Emrecanbl/ESP32-PCB-Drone/Photos/PCB_Bottom_3D_Model.png

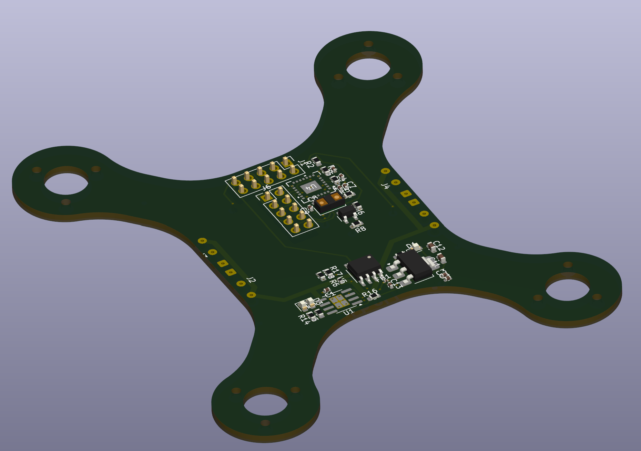
Photos/PCB_Bottom_3D_Model.png
