Emrecanbl/ESP32-PCB-Drone/Photos/PCB_Bottom_Schematic.png

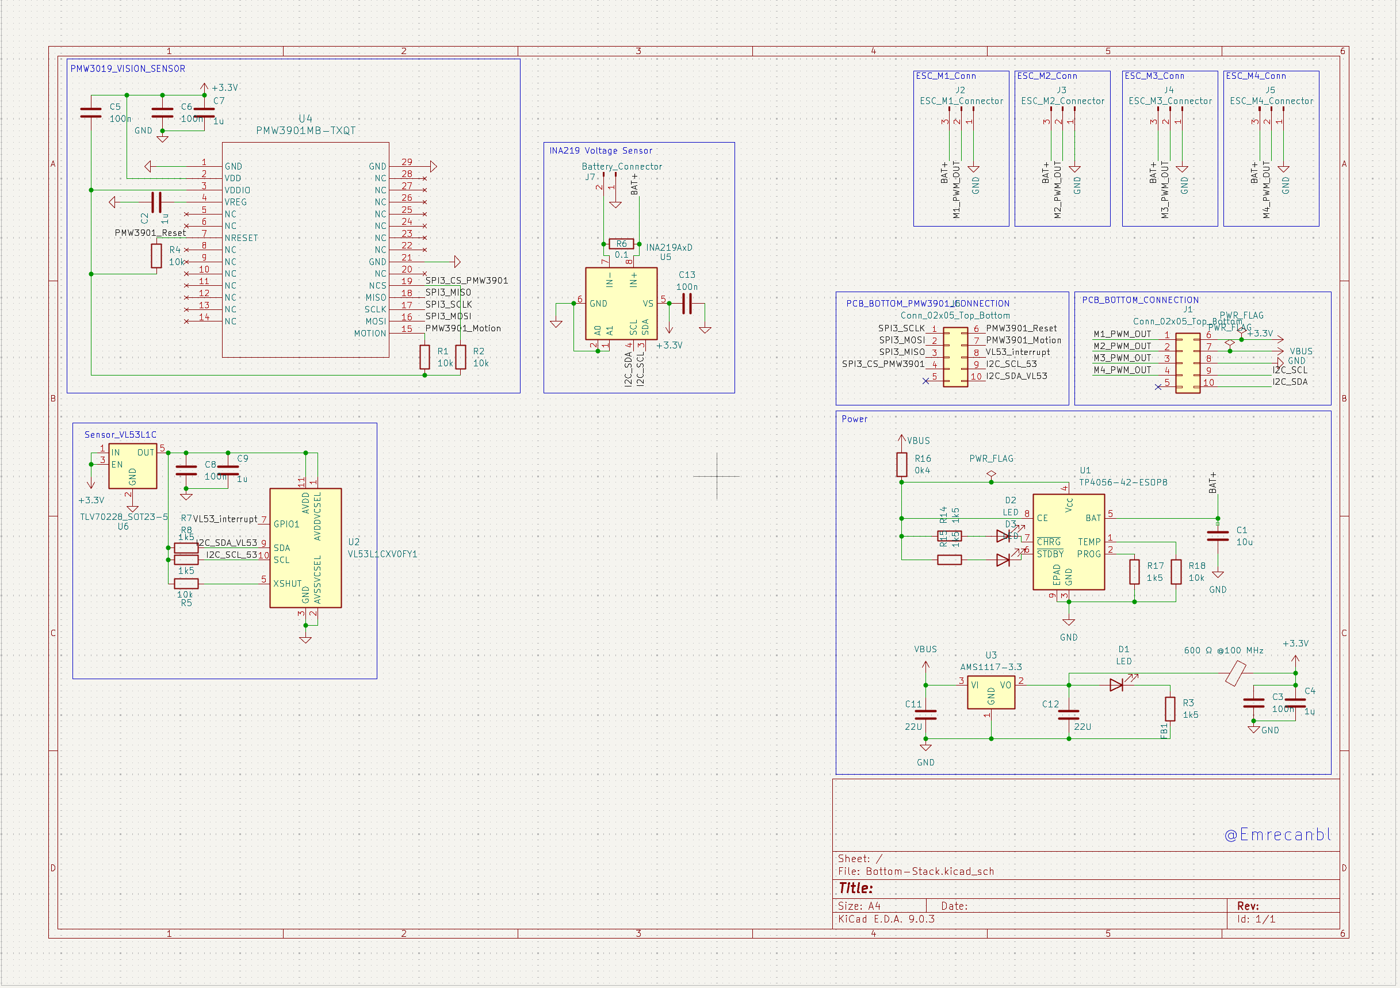
Photos/PCB_Bottom_Schematic.png
