Emrecanbl/ESP32-PCB-Drone/Photos/PCB_Bottom_Tracing.png

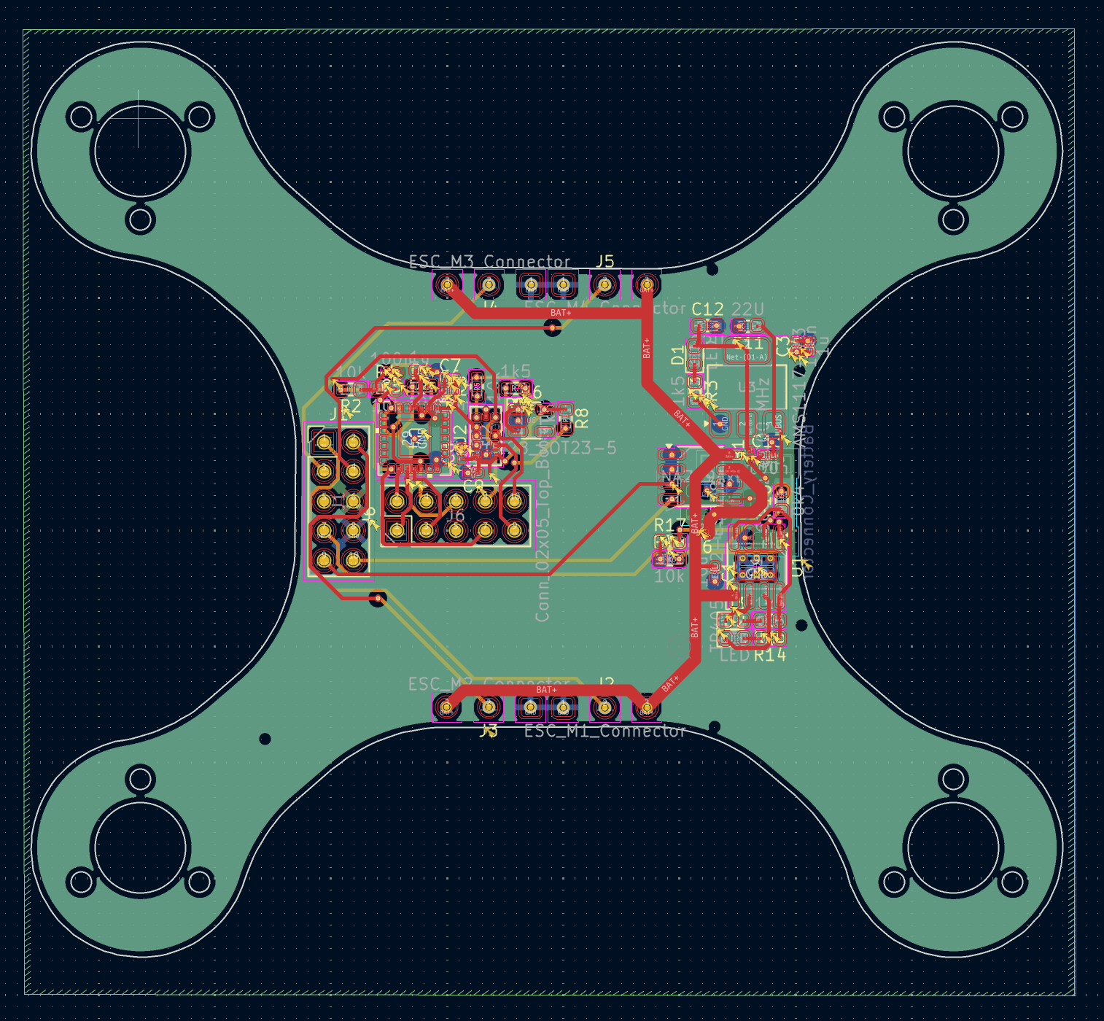
Photos/PCB_Bottom_Tracing.png
