Emrecanbl/ESP32-PCB-Drone/Photos/PCB_Controller_3D_Model.png

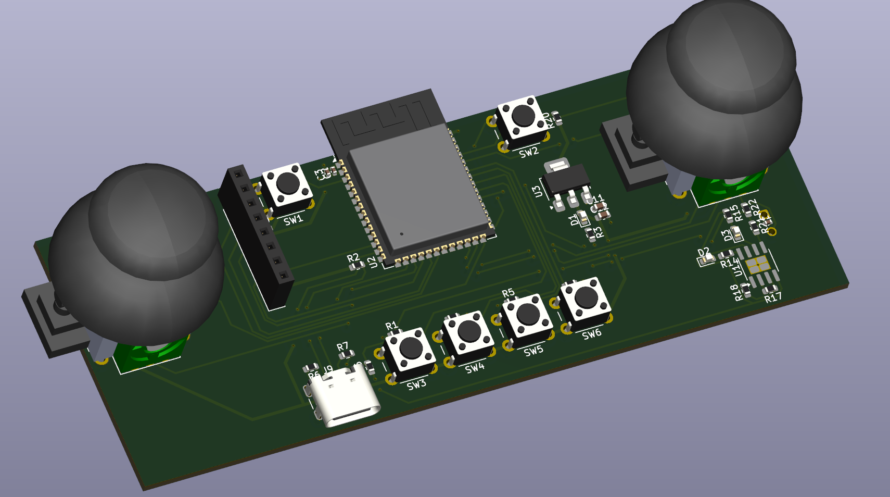
Photos/PCB_Controller_3D_Model.png
