Emrecanbl/ESP32-PCB-Drone/Photos/PCB_Controller_Schematic.png

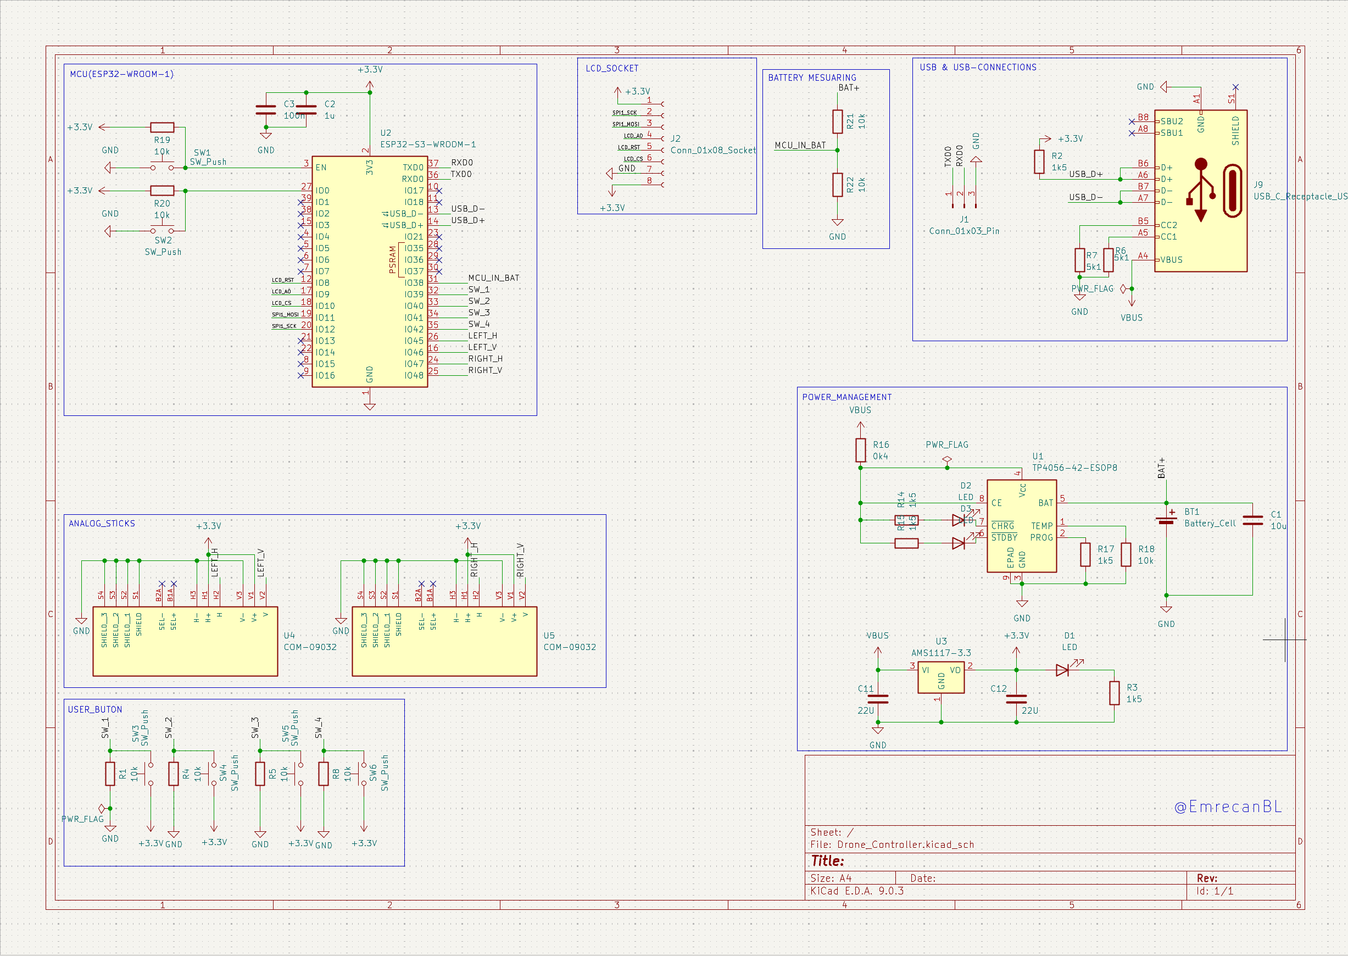
Photos/PCB_Controller_Schematic.png
