Emrecanbl/ESP32-PCB-Drone/Photos/PCB_Controller_Tracing.png

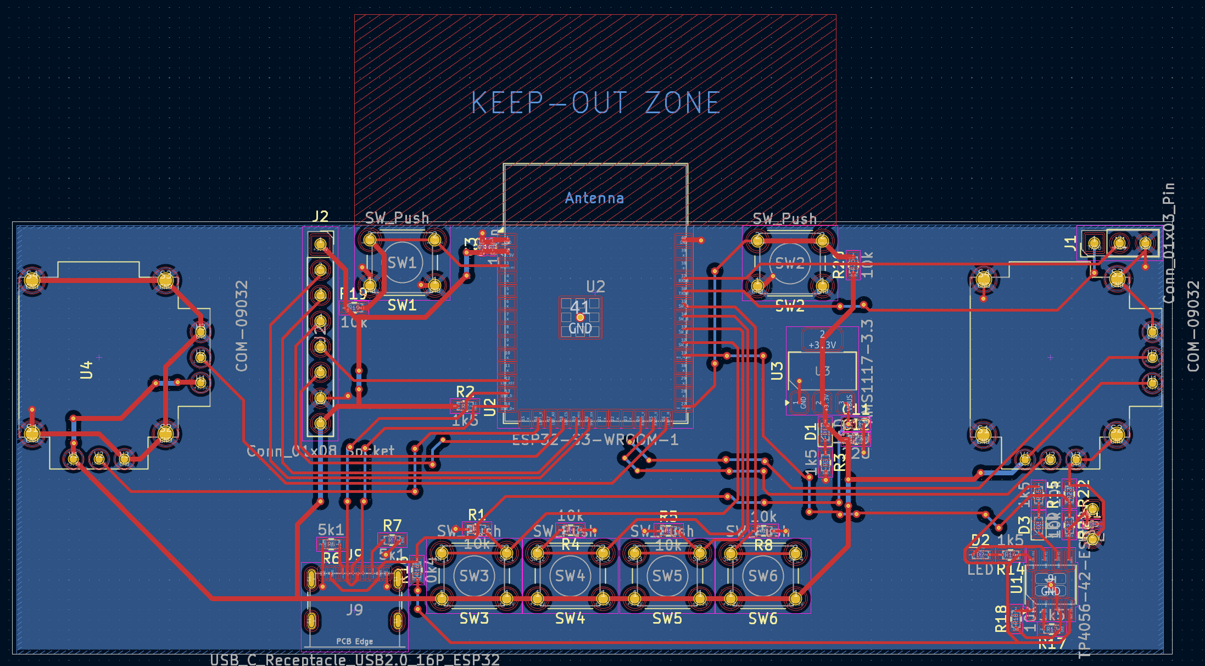
Photos/PCB_Controller_Tracing.png
