Emrecanbl/ESP32-PCB-Drone/Photos/PCB_ESP_3D_Model.png

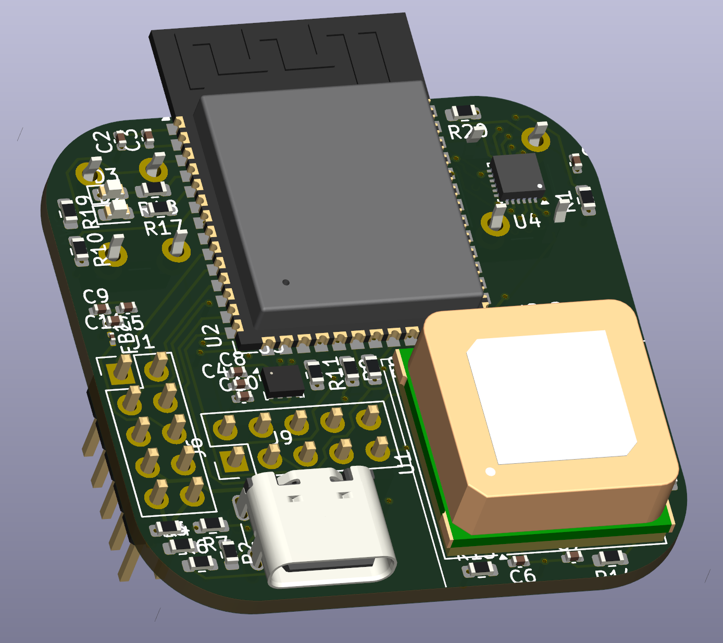
Photos/PCB_ESP_3D_Model.png
