Emrecanbl/ESP32-PCB-Drone/Photos/PCB_ESP_Schematic.png

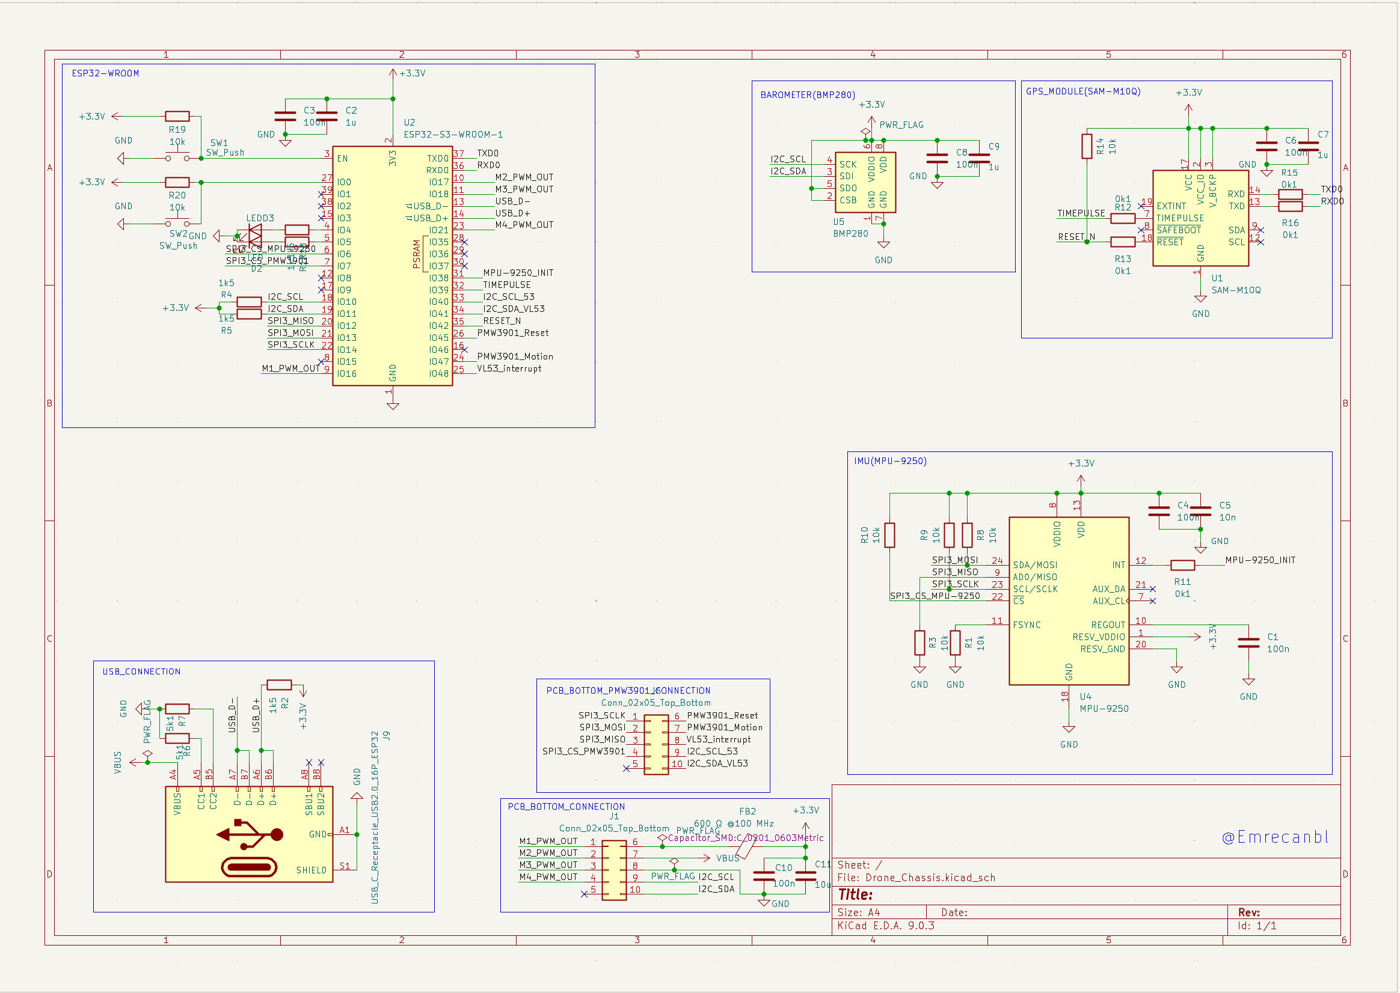
Photos/PCB_ESP_Schematic.png
