Emrecanbl/ESP32-PCB-Drone/Photos/PCB_ESP_Tracing.png

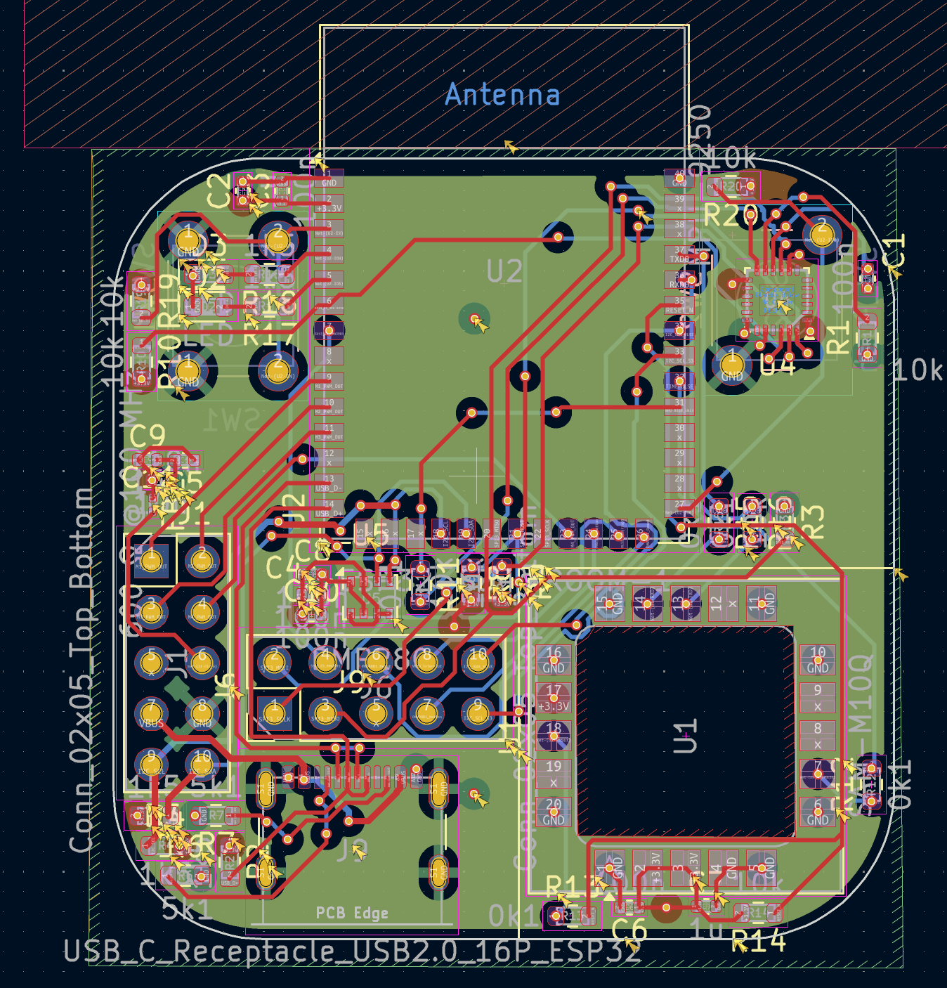
Photos/PCB_ESP_Tracing.png
