Emrecanbl/ESP32-PCB-Drone/PCB_Design/Drone_Controller/JoyStick/COM-09032.step

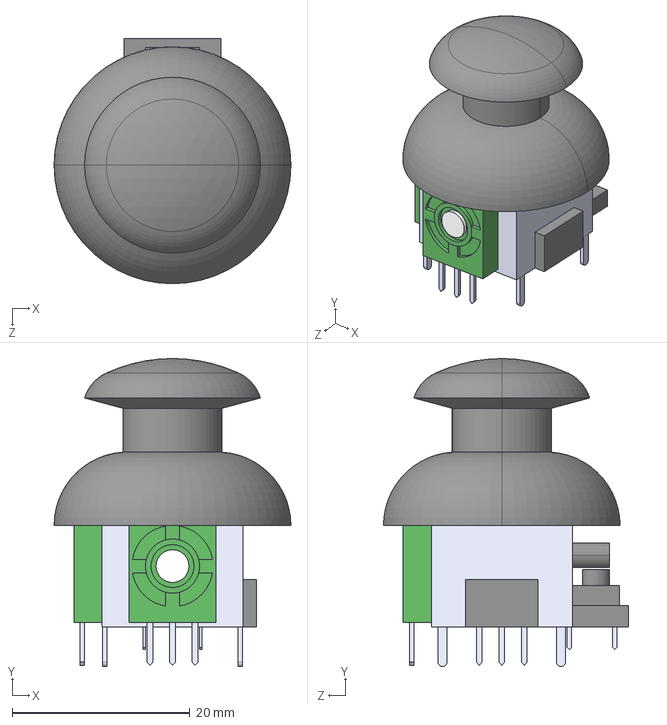
[picture p15: CAD file, 2025-11-06]
PCB_Design/Drone_Controller/JoyStick/COM-09032.step
26.7 x 34.7 x 27.6 mm
