Emrecanbl/ESP32-PCB-Drone/PCB_Design/Drone_Controller/Drone_Controller.kicad_pcb

## KiCad design PCB_Design/Drone_Controller/Drone_Controller.kicad_pcb (2025-11-09)

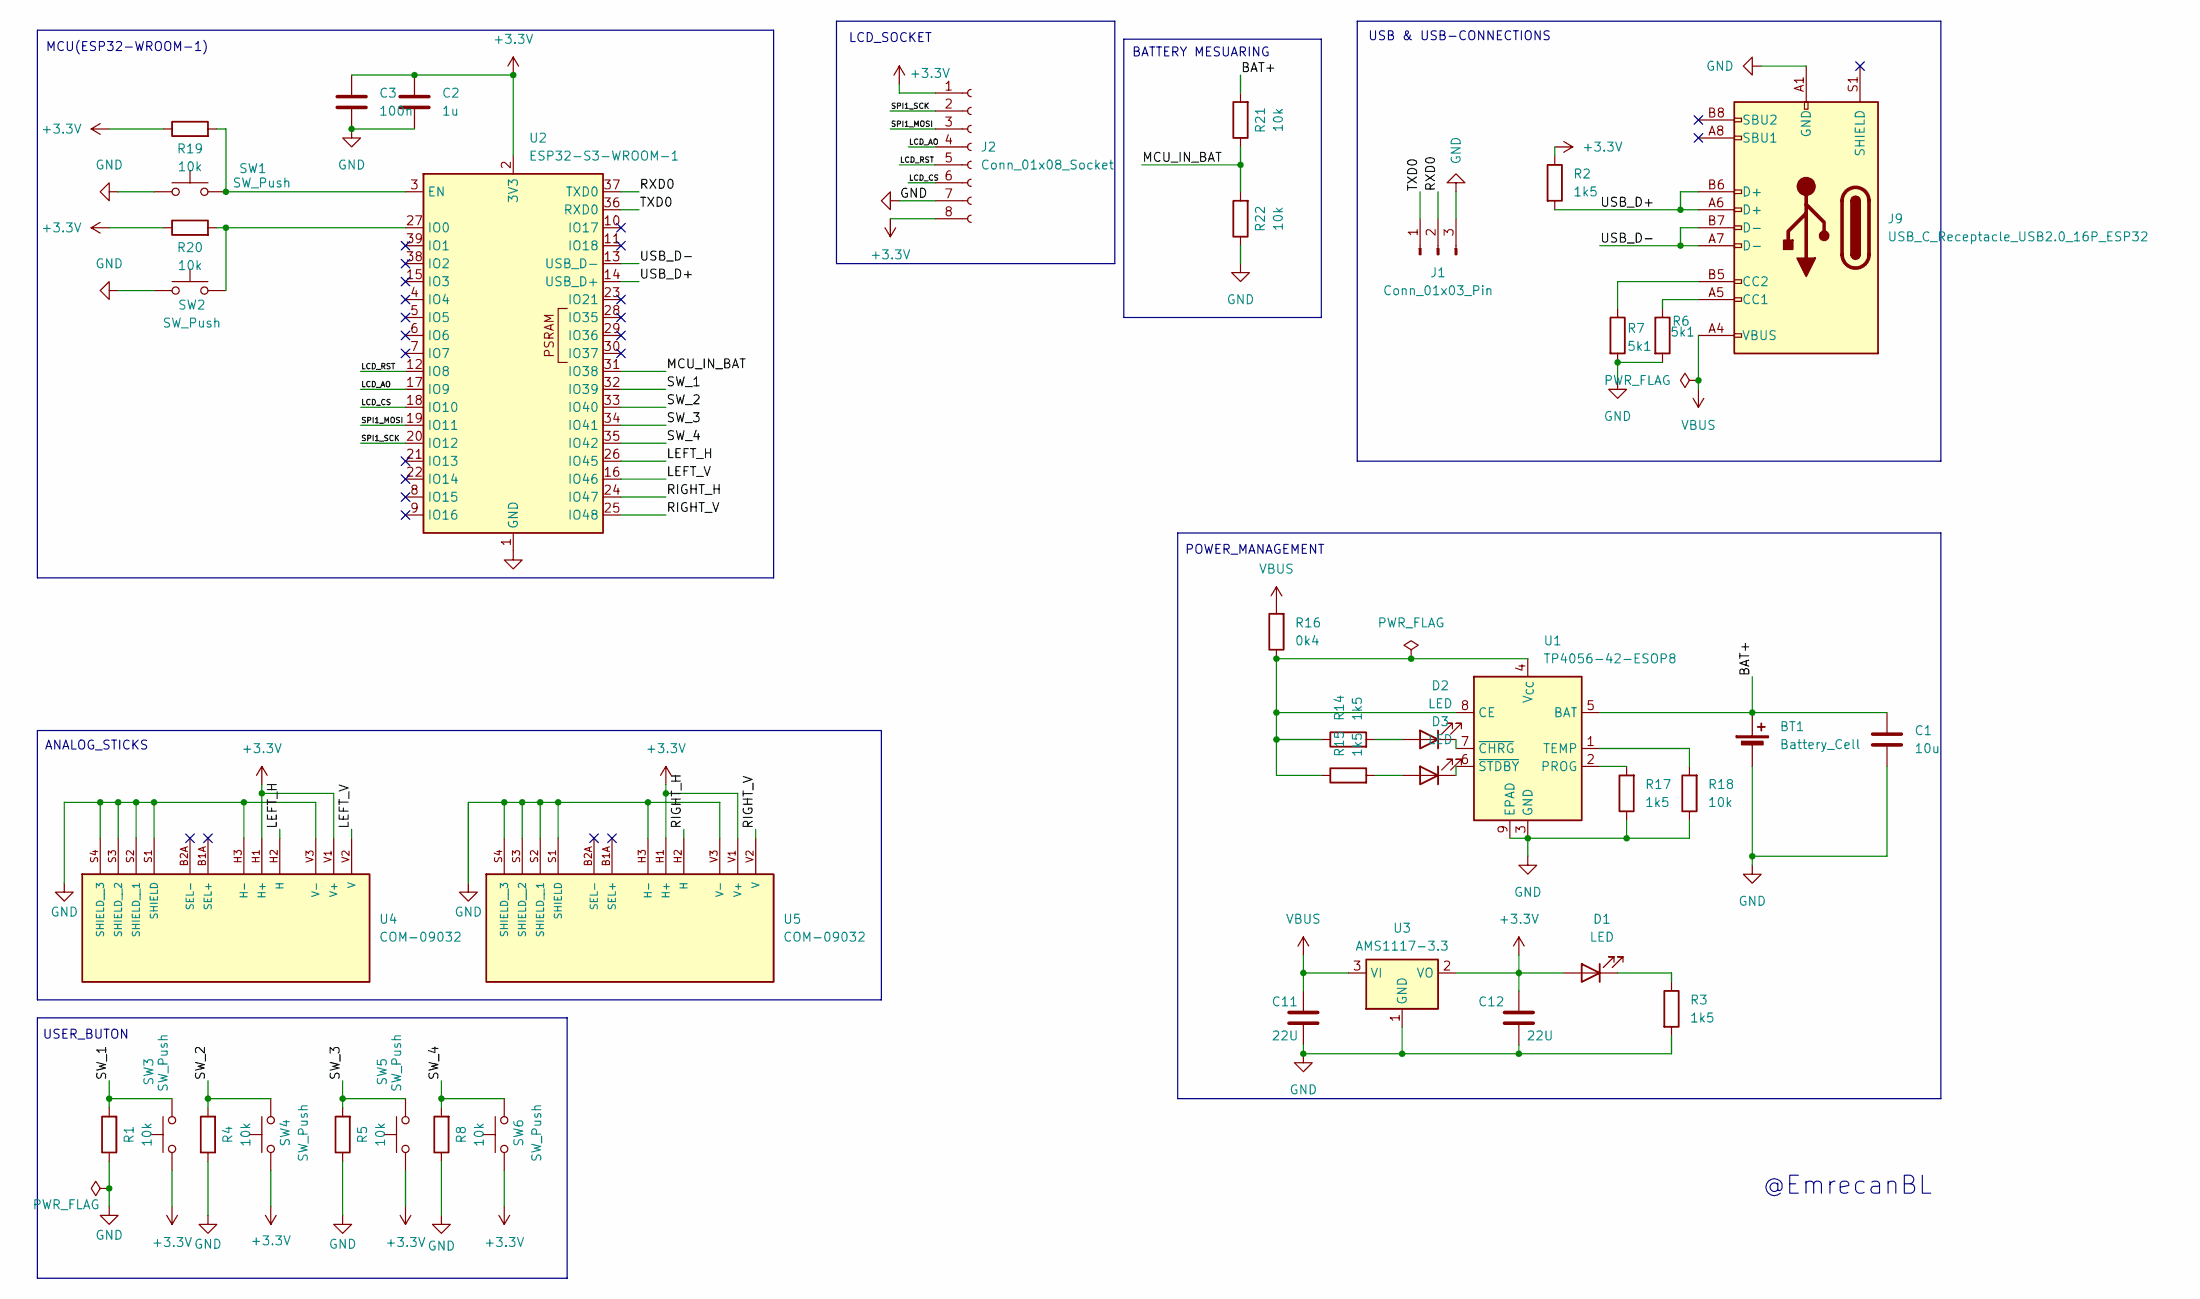
[picture p16: schematic Drone_Controller.kicad_sch]

Parts:
BT1: Battery_Cell; JST_PH_S2B-PH-SM4-TB_1x02-1MP_P2.00mm_Horizontal
C1: 10u; C_0402_1005Metric
C2: 1u; C_0402_1005Metric
C3: 100n; C_0402_1005Metric
C11, C12: 22U; C_0603_1608Metric
D1, D2, D3: LED; LED_0603_1608Metric
J1: Conn_01x03_Pin; PinHeader_1x03_P2.54mm_Vertical
J2: Conn_01x08_Socket; PinSocket_1x08_P2.54mm_Vertical
J9: USB_C_Receptacle_USB2.0_16P_ESP32; USB_C_Receptacle_GCT_USB4105-xx-A_16P_TopMnt_Horizontal
R1, R4, R5, R8, R18, R19, R20, R21, R22: 10k; R_0603_1608Metric
R2, R3, R14, R15, R17: 1k5; R_0603_1608Metric
R6, R7: 5k1; R_0603_1608Metric
R16: 0k4; R_0603_1608Metric
SW1, SW2, SW3, SW4, SW5, SW6: SW_Push; SW_PUSH_6mm_H4.3mm
U1: TP4056-42-ESOP8; SOIC-8-1EP_3.9x4.9mm_P1.27mm_EP2.41x3.3mm_ThermalVias
U2: ESP32-S3-WROOM-1
U3: AMS1117-3.3; SOT-223-3_TabPin2
U4, U5: COM-09032; Analog; PARTREV N/A

Connections:
+3.3V: C2.1, C3.1, C12.1, D1.2 (A), J2.1, J2.8, R2.1, R19.1, R20.1, SW3.1, SW4.1, SW5.1, SW6.1, U2.2 (3V3), U3.2 (VO), U4.H1 (H+), U4.V1 (V+), U5.H1 (H+), U5.V1 (V+)
/BAT+: BT1.1 (+), C1.1, R21.2, U1.5 (BAT)
/LCD_AO: J2.4, U2.17 (IO9)
/LCD_CS: J2.6, U2.18 (IO10)
/LCD_RST: J2.5, U2.12 (IO8)
/LEFT_H: U2.26 (IO45), U4.H2 (H)
/LEFT_V: U2.16 (IO46), U4.V2 (V)
/MCU_IN_BAT: R21.1, R22.2, U2.31 (IO38)
/RIGHT_H: U2.24 (IO47), U5.H2 (H)
/RIGHT_V: U2.25 (IO48), U5.V2 (V)
/RXD0: J1.2, U2.37 (TXD0)
/SPI1_MOSI: J2.3, U2.19 (IO11)
/SPI1_SCK: J2.2, U2.20 (IO12)
/SW_1: R1.2, SW3.2, U2.32 (IO39)
/SW_2: R4.2, SW4.2, U2.33 (IO40)
/SW_3: R5.2, SW5.2, U2.34 (IO41)
/SW_4: R8.2, SW6.2, U2.35 (IO42)
/TXD0: J1.1, U2.36 (RXD0)
/USB_D+: J9.A6 (D+), J9.B6 (D+), R2.2, U2.14 (USB_D+)
/USB_D-: J9.A7 (D-), J9.B7 (D-), U2.13 (USB_D-)
GND: BT1.2 (-), C1.2, C2.2, C3.2, C11.2, C12.2, J1.3, J2.7, J9.A1 (GND), J9.A12 (GND), J9.B1 (GND), J9.B12 (GND), R1.1, R3.2, R4.1, R5.1, R6.2, R7.2, R8.1, R17.1, R18.1, R22.1, SW1.1, SW2.1, U1.3 (GND), U1.9 (EPAD), U2.1 (GND), U2.40 (GND), U2.41 (GND), U3.1 (GND), U4.H3 (H-), U4.S1 (SHIELD), U4.S2 (SHIELD__1), U4.S3 (SHIELD__2), U4.S4 (SHIELD__3), U4.V3 (V-), U5.H3 (H-), U5.S1 (SHIELD), U5.S2 (SHIELD__1), U5.S3 (SHIELD__2), U5.S4 (SHIELD__3), U5.V3 (V-)
unnamed: D1.1 (K), R3.1
unnamed: D2.2 (A), R14.2
unnamed: D2.1 (K), U1.7 (~CHRG)
unnamed: D3.2 (A), R15.2
unnamed: D3.1 (K), U1.6 (~STDBY)
unnamed: J9.A5 (CC1), R6.1
unnamed: J9.B5 (CC2), R7.1
unnamed: R14.1, R15.1, R16.1, U1.4 (V_{CC}), U1.8 (CE)
unnamed: R17.2, U1.2 (PROG)
unnamed: R18.2, U1.1 (TEMP)
unnamed: R19.2, SW1.2, U2.3 (EN)
unnamed: R20.2, SW2.2, U2.27 (IO0)
VBUS: C11.1, J9.A4 (VBUS), J9.A9 (VBUS), J9.B4 (VBUS), J9.B9 (VBUS), R16.2, U3.3 (VI)

Notes on the sheet:
ANALOG_STICKS
MCU(ESP32-WROOM-1)
BATTERY MESUARING
USB & USB-CONNECTIONS
POWER_MANAGEMENT
LCD_SOCKET
USER_BUTON
@EmrecanBL

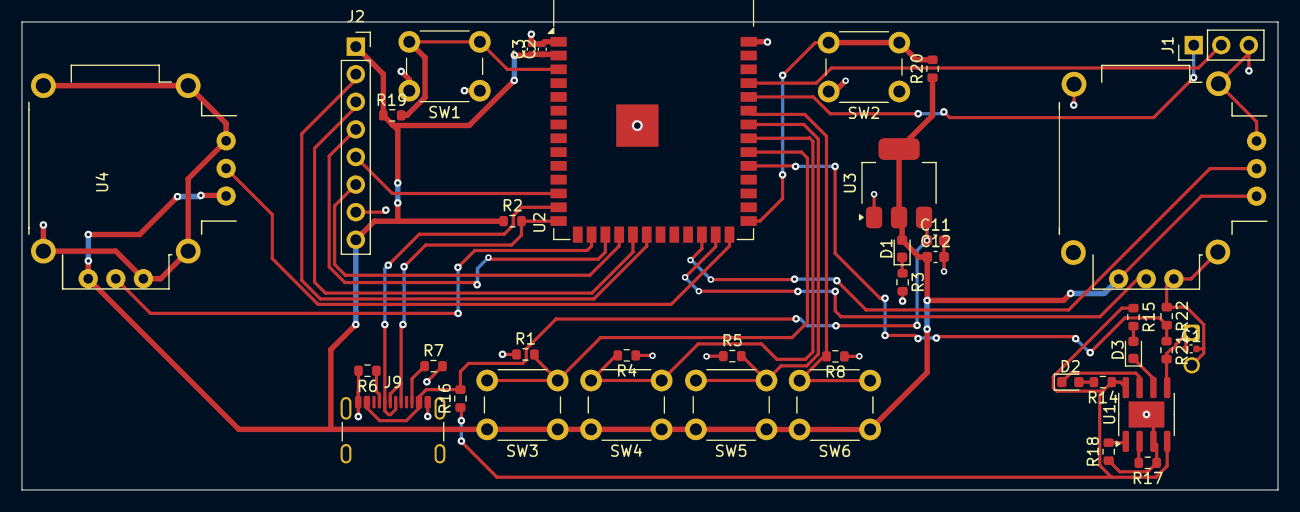
[picture p17: board Drone_Controller.kicad_pcb from above]

Board: 2 copper layers, 115.7 x 43.1 mm, 40 parts (1 on the bottom side), 34 nets.
