Emrecanbl/ESP32-PCB-Drone/(commit log)

2025-11-06 Create New Project
    [COM-09032.step, Drone_Chassis.kicad_pcb, Drone_Chassis.kicad_sch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]
2025-11-29 Revise README for STM32H7 Micro-Drone Project
    Updated the README to reflect the transition from an ESP32-S3 based micro-drone to a STM32H7 flight stack, including new phases and features.
2025-11-29 Add gallery section to README
    Added a gallery section with images of PCB models and schematics.
